AldaFux/Project-206-249/README.md

# Project-206-249
Repository for Final Project of classes 206 and 249
