AldaFux/Project-206-249/SampleMaterial/150708_Workshop_Kinematik.pdf

## Workshop

# Einführung in die Inverse Kinematik

FabLab Nürnberg – Johannes Heberlein

thingiverse.com/joo

## Geometrischer Ansatz zur mathematischen Modellfindung der inversen Kinematik eines quasi parallel verlinkten Roboterarms zur Stellwertfindung polar agierender Aktoren für einen im kartesischem Koordinatensystem agierenden Endeffektor

## Übersicht

- Grundlagen der Geometrie
- Grundlagen der Kinematik
- Übung/Beispiel Parallelroboterarm
- Plotclock erklärt
- Übung

## Geometrische Grundlagen

- Karthesisches und Polars Koordinatensystem – Pythagoras und Arkustangens
- Kosinussatz
- Z-Winkel
- Winkelfunktion Arduino

## Polare und Kartesische Koordinaten

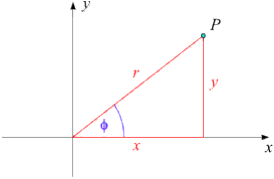
[picture p4: figure]

Kartesische Koordinaten Punkt P:

x = r·cos(φ)

y = r·sin(φ)

Polar Koordinaten

r = √(x² + y²)

tan(φ) = y/x

## Kosinussatz

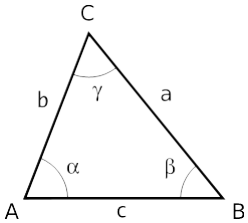
[picture p5: figure]

## Z-Winkel

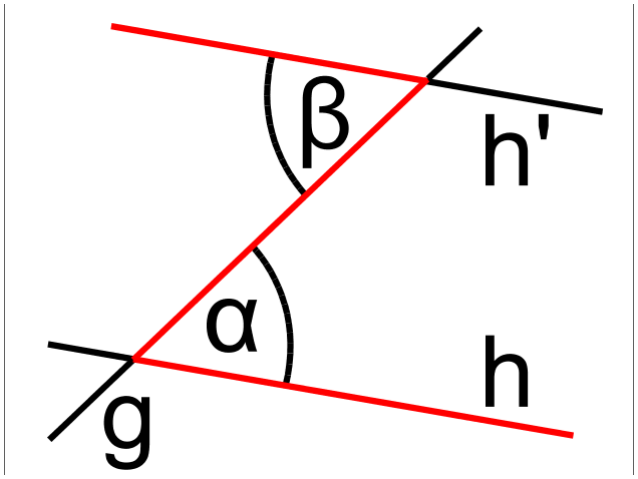
[picture p6: figure]

## Winkel in Arduino

- Winkel in Radian, gegen den Uhrzeigersinn Start bei „3 Uhr“
- atan2 unabhängig vom jeweiligen Quadrant
- Standard in den meisten Programmiersprachen

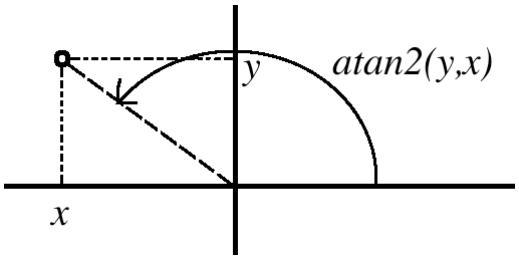
[picture p7: figure]

## Grundlagen der Kinematik

- Unterschied direkte und inverse Kinematik
- Freiheitsgrade
– n Formeln/Aktoren für n Freiheitsgrade
- Aktoren, Gelenke, Lager

## Unterschied direkte und inverse Kinematik

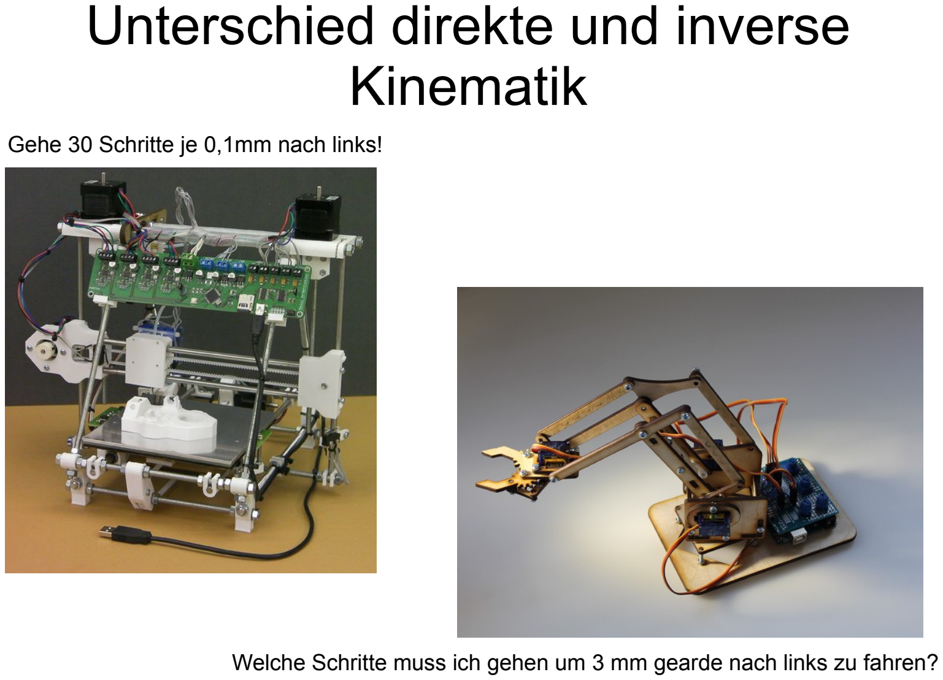
[picture p8: page 10]

Welche Schritte muss ich gehen um 3 mm gearde nach links zu fahren?

Gehe 30 Schritte je 0,1mm nach links!

## Freiheitsgrade

- Anzahl Aktoren bestimmt Anzahl der Freiheitsgrade:
- Lasercutter: 2 Schrittmotoren → 2D
- 3D Drucker: 3 Schrittmotoren → 3D
- Plotclock: 2 Servos (+1 Hub Servo) → „2.5D“

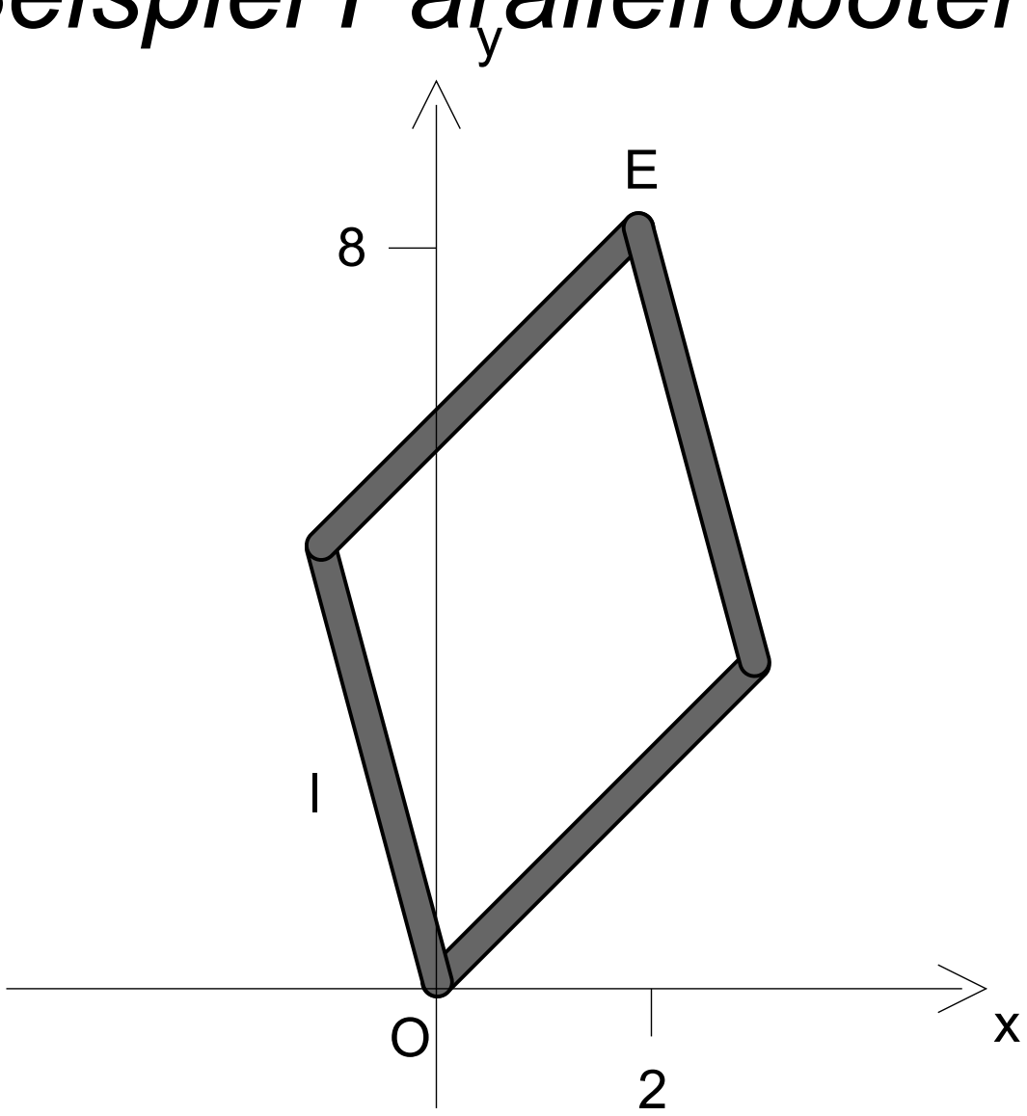
[picture p9: figure]

## Beispiel Parallelroboterarm

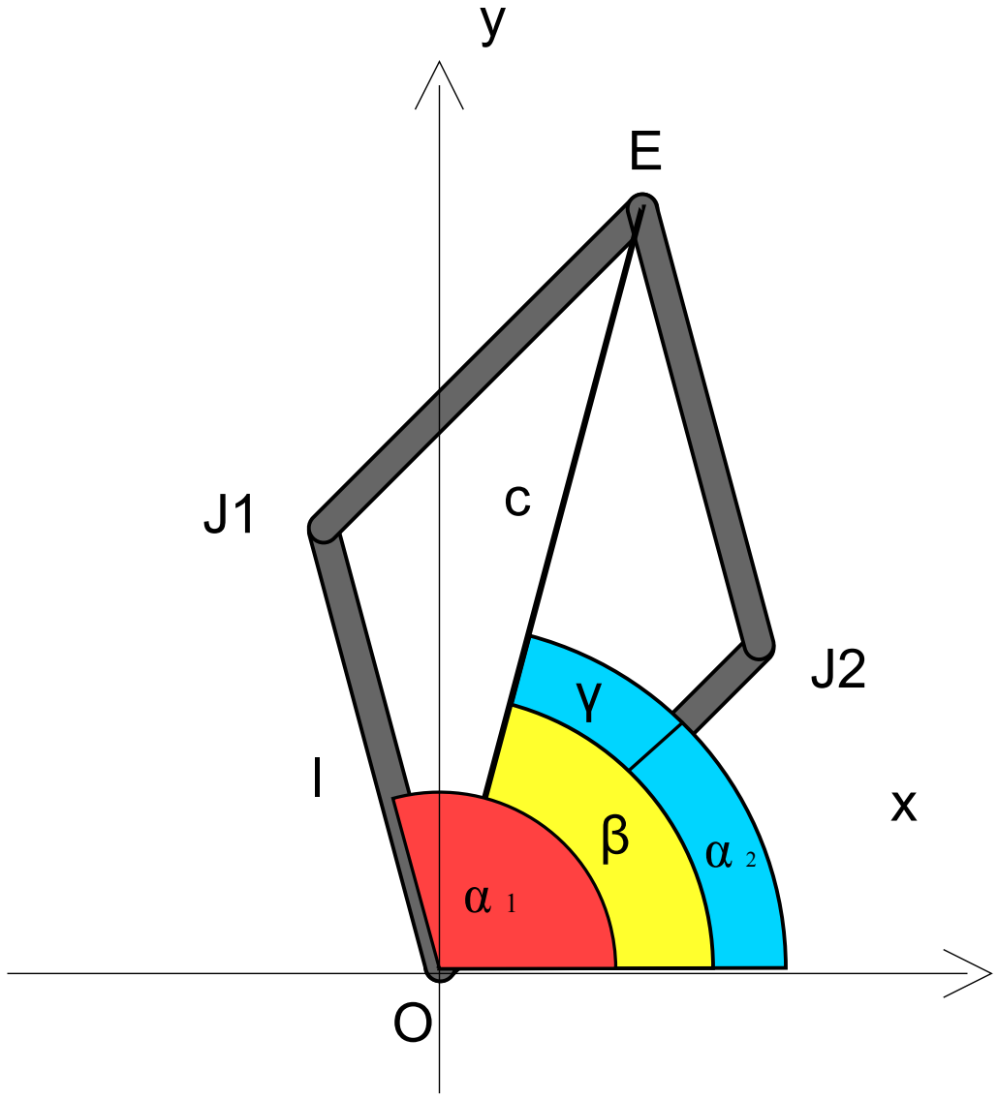
[picture p10: figure]

Gegeben:
O(0,0); E(2,8); l=6

Gesucht:
α 1 ; α 2

Winkelbedingungen:
β=atan2((Ey-Oy), (Ex-Oy))
β=atan2(Ey, Ex) -> 1,32rad

α 1 = β + γ
α 2 = β - γ

c = √((Ey-Oy)²+(Ex-Ox)²)
c = √(Ey²+Ex²) -> 8,25

-> einzig der Winkel γ fehlt

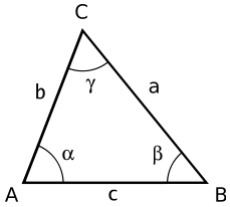
[picture p11: figure]

b²+c²-a²=2bc cos(α)

(b²+c²-a²)/2bc = cos(α)
α = acos( | ) (b²+c²-a²)
2bc
γ = acos( | )

(c*c+l*l-l*l)
2*c*l

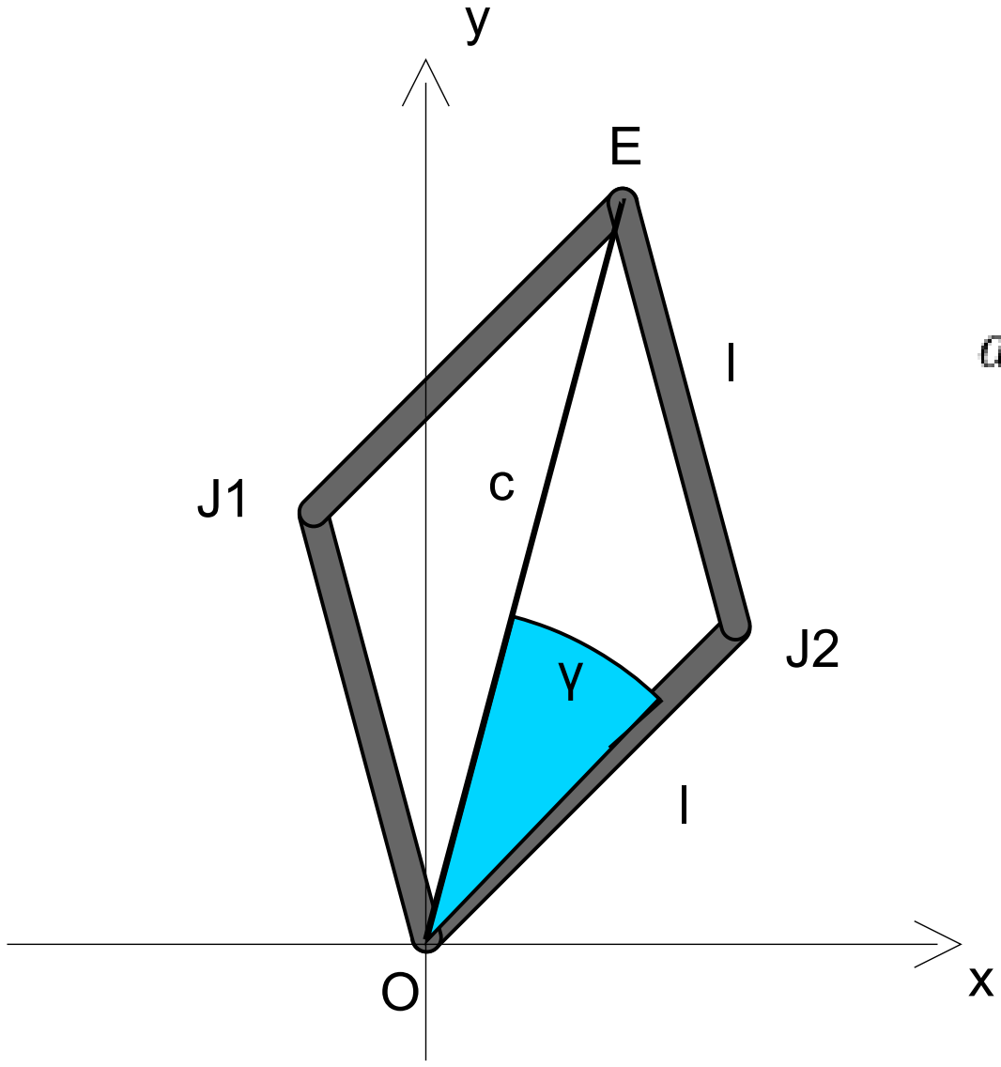
[picture p12: figure]

hier 0,813

γ = acos( )

c
2*l

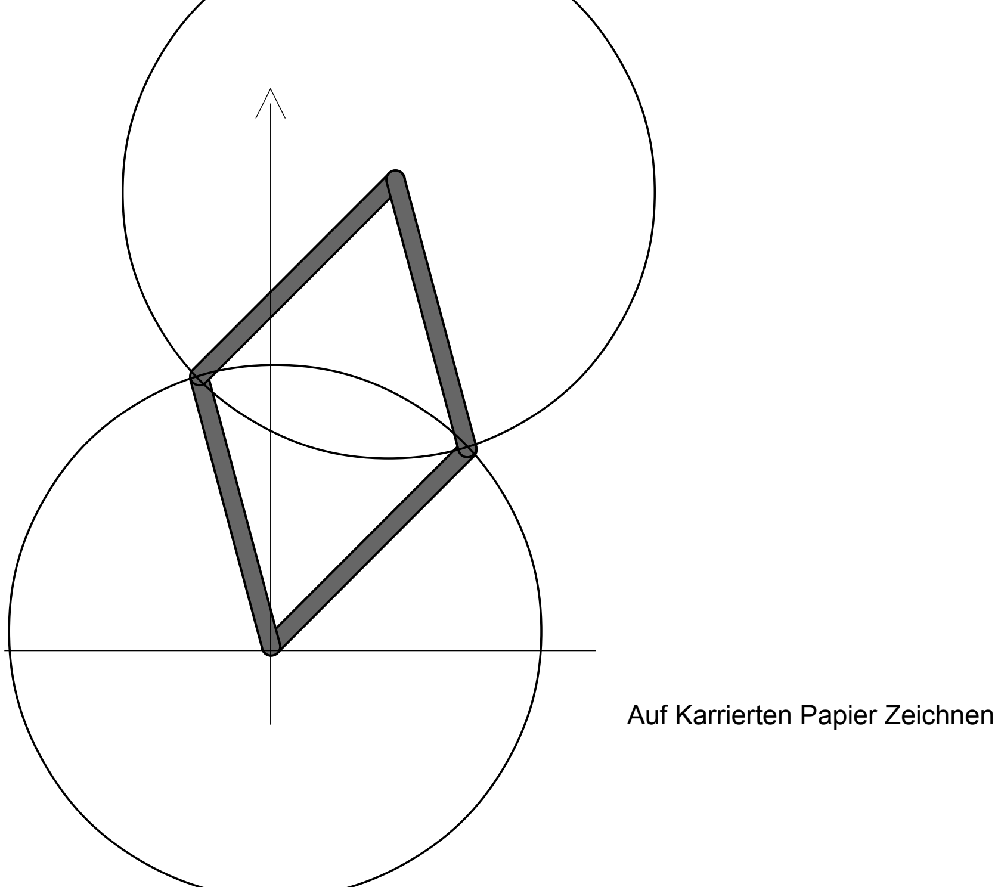
[picture p13: figure]
Auf Karrierten Papier Zeichnen

## Aktoren und Gelenke

- Schiene, Linearaktor, → Linie
- Servomotor, normales Gelenk → Kreis
- Kugelgelenk → Kugel

## Plotclock erklärt

## Vorschlag Übung
