AldaFux/Project-206-249/DocumentsForAssignments/InverseKinematics/InverseKinematicsMap.pdf

## Inverse Kinematics of the Robotic Manipulator

Patrick Scheffe, Nikolas Alberti

December 9, 2016

## 1 Simplified Kinematic Model

A simplified sketch of the robotic manipulator can be seen in Figure 1. As a first approx-imation it is useful to determine the angles θ1 to θ4 from the given position of the joint at which the two arms coincide (x,y). The key for solving this inverse kinematics problem is to divide it into smaller subproblems that each can be solved individually. For that purpose, the line segments a, b and c are introduced.
From the initial information, following values can be directly computed:

α = arctan y
x
(1)
β = π − α | (2)

c =

p
x

2 + y

2 | (3)

a =

s
x +

L3
2

2
+ y
2 | (4)

b =

s
x −

L3
2

2
+ y
2 | (5)

Now, you can solve for θ2 and θ3 by either using sine rule or cosine rule. However, the sine rule can be ambiguous in certain setups, which makes case differentiation necessary. Although mathematically steady, in our implementation the domain crossing from one solution to the other resulted in discontinuities of the movement. Therefore, the cosine rule solution is preferred:

θ2 = arccos

a

2 + ( L3
2

)

2 − c

2

aL3

!
| (6)

θ3 = arccos

b

2 + ( L3
2

)

2 − c

2

bL3

!
(7)

1

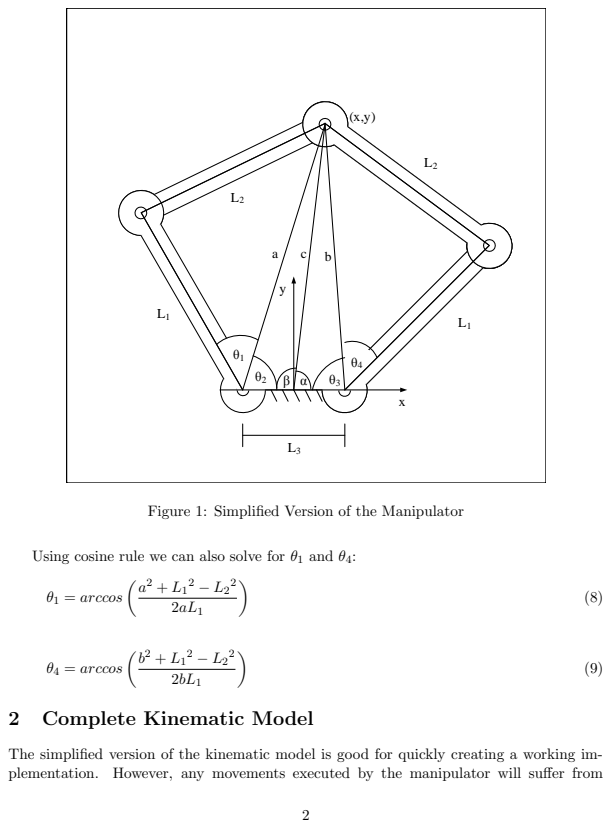
[picture p14: page 2]
θ1 = arccos ; θ4 = arccos 

Figure 1: Simplified Version of the Manipulator

Using cosine rule we can also solve for θ1 and θ4:

2 Complete Kinematic Model

The simplified version of the kinematic model is good for quickly creating a working im-
plementation. However, any movements executed by the manipulator will suffer from

distortion because the pen is not mounted exactly at the joint’s position but in a small distance. Hence, a precise solution is necessary. For that purpose, new definitions must be

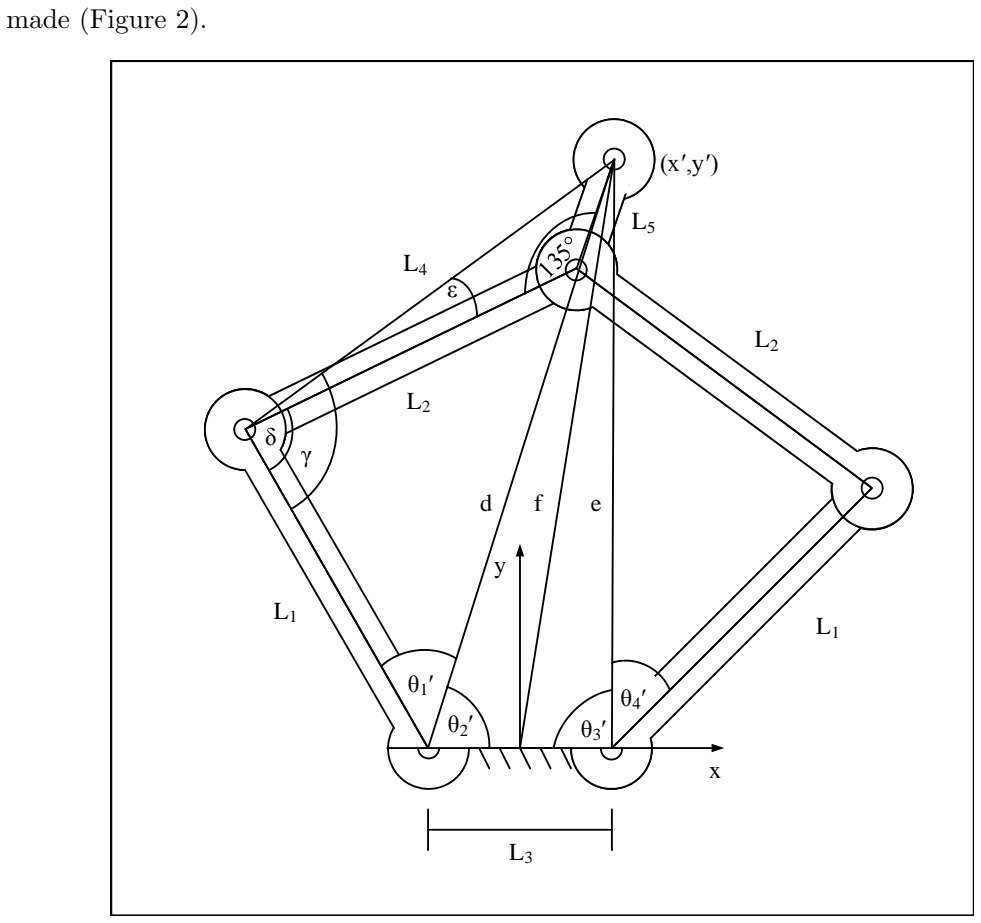
[picture p15: figure]
made (Figure 2).

Figure 2: Simplified Version of the Manipulator

L4 and are fixed measures and not influenced by the position of the manipulator:

L4 =

s
L2

2 + L5

2 − 2L5L2cos
3π
4
(10)

= arccos
L4

2 + L2

2 − L5

2

2L4L2

(11)

d, e and f can be yielded by the Pythagorean theorem:

f =

q
x

02 + y
02
(12)

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
(13)

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
(14)

Now, θ

0/2, θ

0/3 and δ can be computed:

θ

0
2 = arccos

d

2 + ( L3
2

)

2 − f

2

dL3

!
(15)

θ

0
3 = arccos

e

2 + ( L3
2

)

2 − f

2

eL3

!
(16)

δ = arccos
L4

2 + L1

2 − d
2

2L4L1

(17)

δ is the sum of and γ.

γ = δ − | (18)

That allows us to calculate some quantities of the simple kinematics model:

a =

q
L1

2 + L1

2 − 2L1L2cos (γ) | (19)

θ1 = arccos
a

2 + L1

2 − L2

2

2aL1

(20)

θ2 = θ

0
1 + θ

0
2 − θ1 | (21)

Finally, we are able to find the position of the joint at which the two arms coincide:

y = a sin(θ2) | (22)

x = a cos(θ2) −

L3
2

(23)

Now, the methods from section 1 can be used to solve for θ3 and θ4.

4
