AldaFux/Project-206-249/DocumentsForAssignments/ProjectReport149/eecs149-project-template/eecs149-project-template/eec149-template.pdf

# Tic-Tac-Tobot

## [EECS 149/249A Class Project]

## Patrick Scheffe

## p.s@berkeley.edu

## Nikolas Alberti

## nikolas.alberti@berkeley.edu

Department of Electrical Engineering and Computer Science University of California

### Berkeley, CA

## ABSTRACT

## 1. INTRODUCTION

Our charter defines the goal of this project as follows: ”In this project, we want to build a robot that will challenge you to play a game of Tic-Tac-Toe. [...]The robot will control the movement of a whiteboard marker using two servos. The pen will be set up in a construction which has a shoulder and an elbow joint, so it can be moved to a defined x-y-position. The whiteboard is mounted in a fixed position next to the manipulator. First, the robot draws the playing field consisting of nine tiles. A camera will be used for monitoring the player’s move (placing a circle or a cross). Autonomously, the robot will react and make its own move. In order to make space for the human player’s moves, the whole construction should be able to move away from the field.”
This definition specifies well what the robot should be capable of doing. In order to meet the specification, a robotic manipulator must be assembled and controlled. Moreover, a computer vision component must be set up. At the end, a program joins these components, allowing it to keep track of the game and to compute the robot’s next move.

## 2. HARDWARE

## 2.1 Arduino Uno

The Arduino Uno is a microcontroller board equipped with an Atmel ATmega328P microcontroller [Atm]. Arduino is an open-source hardware and software project originated in Ivrea, Italy [Ard]. Hardware and software have been distributed by the founders of Arduino (known as Arduino LLC) and the producer of the official Arduino boards (Arduino S.r.l.). The goal of the Arduino project is to make the development on embedded systems as accessible as possible. For instance, the Arduino IDE completely hides technical details like header files from the user.
The Arduino has 14 GPIO pins from which 6 support pulse width modulation (PWM). Since PWM is needed for controlling servo motors, the Arduino matched our requirements. A plus point on the Arduino was that it promised to offer an uncomplicated development.

## 2.2 Servo Motors

For the actuation, we used three Tower Pro MG90S servo motors [Ser]. The connection to the Arduino was established with ordinary jumper cables. The power from a 5V/2A power supply was distributed with a breadboard to provide power for all three servo motors. Because the power supply originally ended in a coaxial power connector, we modified it to have jumper cables as output for positive and negative voltage.

## 2.3 Additional Materials

Additionally, the following materials have been used:

- A Microsoft LifeCam HD-3000 webcam
- A white board
- Two white board markers
- Some screws, nuts and bolts
- ABS filament for 3D printing the custom parts

## 3. ROBOTIC MANIPULATOR

## 3.1 Choosing the dimensions

For accurate two dimensional actuation, a classical robotic manipulator that consists of a chain of dependent joints is not suitable for a low budget approach. The plotclock, a project by Johannes“Joo”Heberlein from the Fablab Nuremberg (comparable to a makerspace) impressively proved a way to make low budget 2D actuation work [Joo]. Therefore, we planned to choose a similar manipulator. However, while the plotclock needs to cover a range whose dimensions in x-direction exceed the dimensions in y-direction, it was not possible to blindly adapt the manipulator. For our project, actuation needs to be performed in a square area. Therefore, we needed to find the optimal sizes of the limbs. This problem can be described as a minimization problem: The area of a square is given. Find the dimensions L1, L2 and L3 that minimize the sum L1 + L2 + L3 while not violating the constraints that the given square fits into the reachable range of the actuator.
Unfortunately, the function of the largest reachable square A(L1, L2, L3) is not defined by a function that allows for partly deriving towards L1, L2 and L3 and setting the derivations to zero. Formulating this problem as a minimization problem to solve with MATLAB for example seemed to WAAAAAAS. We therefore chose to model the reachable space in a geometry software called Geogebra, an open source software for supporting mathematical education in schools and universities [Geo]. Then, we empirically derived a near optimal sizing that yields a reachable square of approximately 100cm²
(Figure 2). A constraint was that we


Figure 1: Geogebra Sketch Used for Sizing

wanted the player to face the robot like they would sit on opposite ends of a table. Consequently, choosing orientation of the square freely to allow a better usage of the space was not possible.

## 3.2 Manufacturing

Finding the right dimensions was a crucial part for building the robot. After finding those, a CAD model of the manipulator was created using Autodesk Inventor [cad]. Those models were converted to STereoLithography (STL) files and printed with the ROSTOCK MAX v3 3D printer in the Supernode lab [3D]. It was important to find the right bed temperature and extrusion speed to avoid warping and have the parts stick to the printing bed.
The joints of the five-bar linkage robot were connected with screws and washers of the right size. To allow the arms of the robot to lift from the whiteboard, the two servomotors actuating the arms can be tilted backwards with a bar connected to their mounting. This bar is also connected to the third servomotor, which is mounted below the whiteboard.

## 3.3 Simplified Kinematic Model

A simplified sketch of the robotic manipulator is shown in Figure 2. As a first approximation it is useful to determine the angles θ1 to θ4 from the given position of the wrist joint at which the two arms coincide (x,y). The key for solving this inverse kinematics problem is to divide it into smaller subproblems that each can be solved individually. For that purpose, the line segments a, b and c are introduced.
From the position of the wrist joint, the following values can be computed directly:

α = arctan

y
x

β = π − α

c =

p
x² + y

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
Now we can solve for θ2 and θ3 by either using sine rule or cosine rule. However, the sine rule can be ambiguous in certain setups, which makes case differentiation necessary. Although mathematically steady, in our implementation the

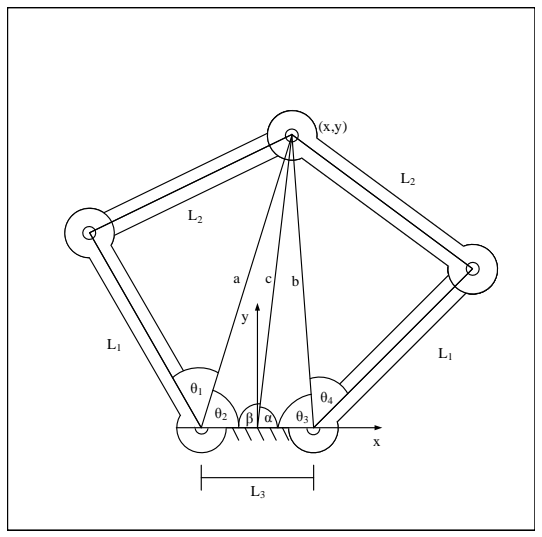
[picture p16: figure]

Figure 2: Simplified Version of the Manipulator

domain crossing from one solution to the other resulted in discontinuities of the movement. Therefore, the unambiguous cosine rule solution is preferred:

θ2 = arccos

a

2 + ( L3
2

)

2 − c

2

aL3

!

θ3 = arccos

b

2 + ( L3
2

)

2 − c

2

bL3

!

Using cosine rule we can also solve for θ1 and θ4:

θ1 = arccos
a

2 + L1

2 − L2

2
2aL1

θ4 = arccos
b

2 + L1

2 − L2

2
2bL1

## 3.4 Complete Kinematic Model

The simplified version of the kinematic model is good for quickly creating a working implementation. However, any movements executed by the manipulator will suffer from distortion. The pen is not mounted exactly at the joint’s position but in a small distance. Hence, a precise solution is necessary. For that purpose, new definitions are made as shown in Figure 3.
L4 and are fixed and not influenced by the position of the manipulator:

L4 =

s
L2

2 + L5

2 − 2L5L2cos
3π
4

= arccos
L4

2 + L2

2 − L5

2
2L4L2

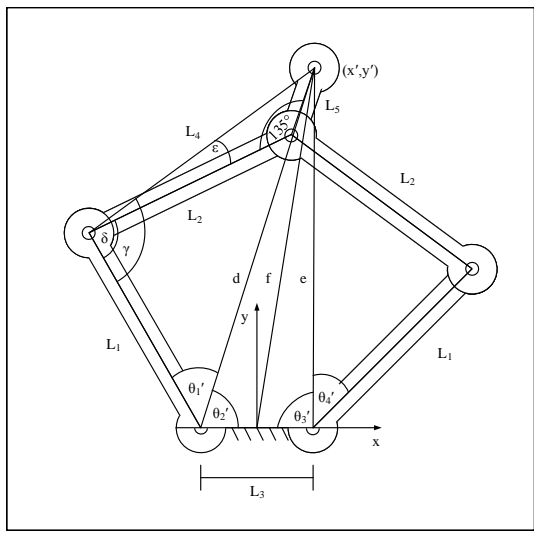
[picture p17: figure]

Figure 3: Complete Version of the Manipulator

d, e and f are found with the Pythagorean theorem:

f =

p
x⁰² + y

02

d =

s
x⁰ +

L3
2

2
+ y

02

e =

s
x⁰ −

L3
2

2
+ y

02

Now, θ

0
2, θ

0
3 and δ can be computed using cosine rule:

θ

0
2 = arccos

d

2 + ( L3
2

)

2 − f

2

dL3

!

θ

0
3 = arccos

e

2 + ( L3
2

)

2 − f

2

eL3

!

δ = arccos
L4

2 + L1

2 − d

2
2L4L1

δ is the sum of and γ.

γ = δ −

That allows us to calculate some quantities of the simple kinematics model:

a =

q
L1

2 + L1

2 − 2L1L2cos (γ)

θ1 = arccos
a

2 + L1

2 − L2

2
2aL1

θ2 = θ

0
1 + θ

0
2 − θ1

Finally, we are able to find the position of the joint at which the two arms coincide:

y = a sin(θ2)

x = a cos(θ2) −

L3
2
Now, the methods from subsection 3.3 can be used to solve for θ3 and θ4.

## 3.5 Modeling the Servo Motors

Servo motors are motors that do not support continuous motion but can be driven to a desired angle precisely. Three cables with different colors connect to the servo motors. The black cable should be connected to ground and the red one to VDD (roughly 5V). These two cables supply the servo motor with the necessary power. The third cable (white, yellow or orange) carries the control signal. The control is done by PWM. The servo motor expects to receive a pulse every 20 ms with a pulse width between 1 ms and 2 ms. The servo motor assumes its most positive position at the the pulse width of 1 ms and the most negative position at a pulse width of 2 ms as defined in the mathematical direction of rotation. The range in between these extrema can be assumed to be linearly covered, i.e. a pulse width of 1.5 ms should yield the position in between these positions. The function that maps the pulse width to an angular position of the servomotor is:
Angle(tpulse) = tpulse − 1 ms
2 ms − 1 ms
- (Anglemax − Anglemin)

+ Anglemin, 1 ms ≤ tpulse ≤ 2 ms

This is just a model of the movement of the servo motors. There are three causes making the actual behavior deviate from the model:

- A high torque forces the servo motors from leaving its desired position.
- The backlash of the gears in the servo motors adds an inaccuracy to the position.
- Non-linearities make the servomotor cover the range of movement not evenly.

Furthermore, when the pulse width modulation signal is created by a digital signal, a quantization error occurs. As you can see, the model makes some approximations. The inner of the servo motor is treated as black box. However, adding the details would bloat the model and the gain is questionable. The proposed model is precise enough to be useful but not so complex that it becomes cumbersome.

## 4. SOFTWARE ON THE ARDUINO

## 4.1 Overview over the software structure

Every program written with the Arduino IDE consists of the function void i n i t ( ) and void l o o p ( ). The i n i t ( ) function is executed once at startup and afterwards the Arduino keeps looping through the l o o p ( ) function. That is, because as a typical microcontroller, the Atmel ATmega328P, does not have an operating system and can not just end a task. In addition, following major functions have been defined:

- void l owe r ( ) lowers the marker.
- void l i f t ( ) removes the marker from the surface.
- void c alcul a teSe r v oM ap (double x prime ,
double y prime , double* | s e r v o L s ol l ,
double* | s e r v o R s o l l ) calculates the values that
should be written to the servo motors given an x-yposition.

- void s e t s e r v o s (double x , double y ) calls c alcul a teSe r v oM ap and writes to the servo motors.
- void g o t o (double xto , double yto ) interpolates between the current position and the desired position of the manipulator and successively sets the position of the servo motors using s e t s e r v o s ( ) in order to achieve a smooth movement between the origin and the destination position.
- void draw { c r o s s , c i r c l e }(double x o f f s e t , double y o f f s e t ) draws cross/circle to any position defined by a passed x-y-position.
- d r a w f i e l d ( ) draws the playing field.

The main functionality is implemented in the l o o p ( ) function: The processor waits for an instruction coded in a byte sent from the master. Once it receives the command, it is executed and followed by sending an acknowledgment signaling that it has finished the execution.

## 4.2 Controlling the Servo Motors

The Arduino Uno has six PWM pins available. Very conveniently, the Arduino IDE already is equipped with a library Servo. This library allows us to instantiate objects of the type Servo. The most important functions on this object are a t t a c h ( ) and w ri t e ( ). The a t t a c h ( ) function assigns the Servo object to a GPIO pin. The w ri t e ( ) maps an angle in the range of 0◦

to 180◦
to a pulse width and
makes the attached GPIO pin output the according PWM. Inherently, a reachable range of 180◦
is assumed for the servo
motor. However, our servo motors only are capable of spinning 150◦
. Signals that exceed the range of approximately 15◦

to 165◦
are simply ignored.
Additionally, the servo hat can only be placed onto the servo motor at certain angles. Therefore, the angle due to this offset also needs to be considered.

#def ine le f tM ax 161

#def ine rightMax 16

void c alcul a teSe r v oM ap ( . . . ) {
* s e r v o L s o l l = le f tM ax − ( pi − ( t h e t a 1+t h e t a 2 ) ) * 180/ pi ; * s e r v o R s o l l = rightMax + ( pi − ( t h e t a 3+t h e t a 4 ) ) * 180/ pi ;
}

Listing 1: Finding the right angle

## 5. SOFTWARE ON THE COMPUTER

## 5.1 Computer Vision

The Python package OpenCV [CV] was used to process the images from the camera in order to register the user input. The basic steps to find the lines drawn on the whiteboard are to convert the image to grayscale and then to binarize it to black and white.
There are two main tasks for the vision: The first is to detect where the field is drawn, so the circle or cross drawn by the user can be assigned to a specific tile of the field. This

Figure 4: Convexity defects for a cross

is achieved by looking for the innermost contour of the lines drawn. Wrong detection is avoided by thresholding with the contours enclosed area. The corners of this inner field is then transformed so that the field coordinates are mapped to pixels.
The second task is to decide if the input drawn by the user is a cross or a circle. The convexity defects were used as the property of those signs to tell them apart. The convexity defects quantify the local maximum of the deviation of the contour to its convex hull as shown in Figure 4. For a circle or a different convex shape, there should be no convexity defects at all. Every convex shape will be detected as a circle consequently. This method of detection can therefore produce wrong rights, but the differentiation between circles and crosses is robust.

## 5.2 Tic-Tac-Toe AI

The simple and well known game Tic-Tac-Toe is already fully explored and algorithms to play the game optimally are available. Also, the relatively small state space of the board make exhaustive search for an optimal solution possible. The concept of the algorithm used in our implementation is nicely explained in [NSB]. Furthermore, [vdS] provides a similar implementation of the game in Python. Although it heavily relies on the functions only available in a GUI environment, it served as a useful reference.
Since the detailed explanation can be found in [NSB], only the principle is summarized here: A 3×3 2D-array represents the nine tiles in the field. On each move, the algorithm iterates over the tiles and when it encounters an empty tile, it recursively calls itself to simulate the progress of the game. Doing so, an altered board with the new move and another active player is passed. The break condition is either that one of the players has won or there is no free gap anymore. The original caller chooses the move that offers the best outcome with the minimum number of recursive calls in case of a win and the maximum number of recursive calls in case of a loss. It is a typical example of a minimax algorithm. The described algorithm plays optimally, in a meaning that it is impossible to win against it. Also, in case a win can be enforced, the computer finds this optimal path to the win. It lacks an understanding for common human mistakes and assumes the opponent to play optimally himself. In order to offer some kind of a sense of achievement to the player, the algorithm is disabled with a probability of 15%

and a random move is made.

## 5.3 The Game Program

Having described each part separately, the only thing left is combining each part to form a robot that autonomously plays Tic-Tac-Toe. A superordinate loop sets up the playing field and reads the player’s decision whether he wants to start or not. In order to completely decouple the game from an input on the computer, we made the design choice that the first player’s sign is the cross and the second player’s sign is the circle. With that definition, the decision whether the player or the computer should start the game is made by drawing either a cross (“I want to start!”) or a circle (“The computer should start!”) to the right of the playing field. Once the setup is done, a subordinate loop is started that breaks after nine subsequent moves or when on one of the players has won.
For the serial communication with the Arduino, the library p y s e r i a l [PyS] has been used.

## 6. REFERENCES

[Atm] Atmel: ATmega328P Manual (https://cdn.sparkfun.com/datasheets/Kits/doc8161.pdf.)
[Ard] Arduino LLC: Arduino UNO & Genuino UNO (https://www.arduino.cc/en/Main/ArduinoBoardUno) [Ser] Adafruit: Micro Servo - MG90S High Torque Metal Gear (https://www.adafruit.com/products/1143)
[Joo] Johannes “Joo” Heberlein: Plotclock, (http://www.thingiverse.com/thing:248009) Nuremberg(2014), published under the Creative Commons - Attribution license (https://creativecommons.org/licenses/by/3.0/)
[Geo] Markus Hohenwarter et al.: Geogebra, software published under a free, non-commercial license; (https://www.geogebra.org/license) source code (https://dev.geogebra.org/trac) published under the GNU General Public License (http://www.gnu.org/licenses/gpl.html)
[cad] Autodesk: Inventor (http://www.autodesk.de/products/inventor/overview)
[3D] SeeMeCNC: ROSTOCK MAXˆaD´c V3 DESKTOP ˇ 3D PRINTER DIY KIT (https://www.seemecnc.com/products/rostock-max-v3-desktop-3d-printer-diy-kit)
[CV] Itseez: OpenCV, (http://opencv.org) software published under a BSD-license (http://opencv.org/about.html)
[NSB] Never Stop Building LLC: Tic Tac Toe: Under standing The Minimax Algorithm(2013) (http://neverstopbuilding.com/minimax)
[vdS] Mauritz van der Schee: Python TicTacToe with Tk and minimax AI(2013) (https://www.leaseweb.com/labs/2013/12/python-tictactoe-tk-minimax-ai/)
[PyS] Chris Liechti:pyserial(2001) (https://pythonhosted.org/pyserial/)
