AldaFux/Project-206-249/DocumentsForAssignments/ProjectReport149/eecs149-project-template/eecs149-project-template/flies-eps-converted-to.pdf

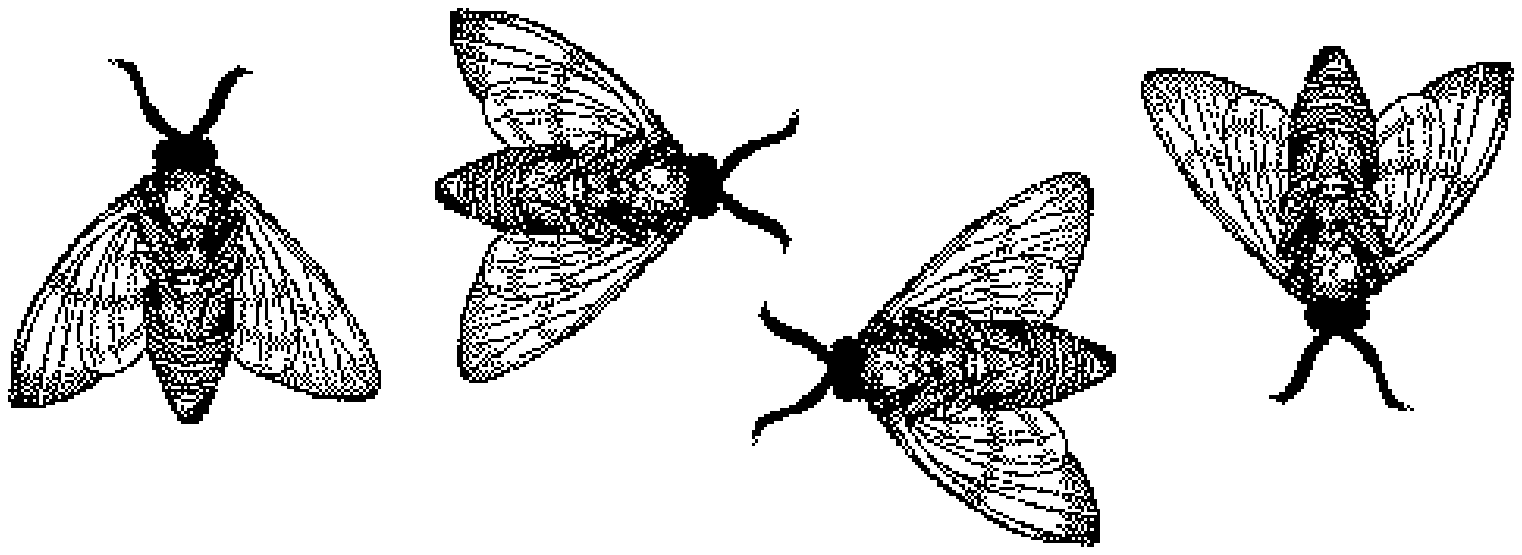
[picture p18: page 1]
