AldaFux/Project-206-249/DocumentsForAssignments/ProjectReport149/eecs149-project-template/eecs149-project-template/fly-eps-converted-to.pdf

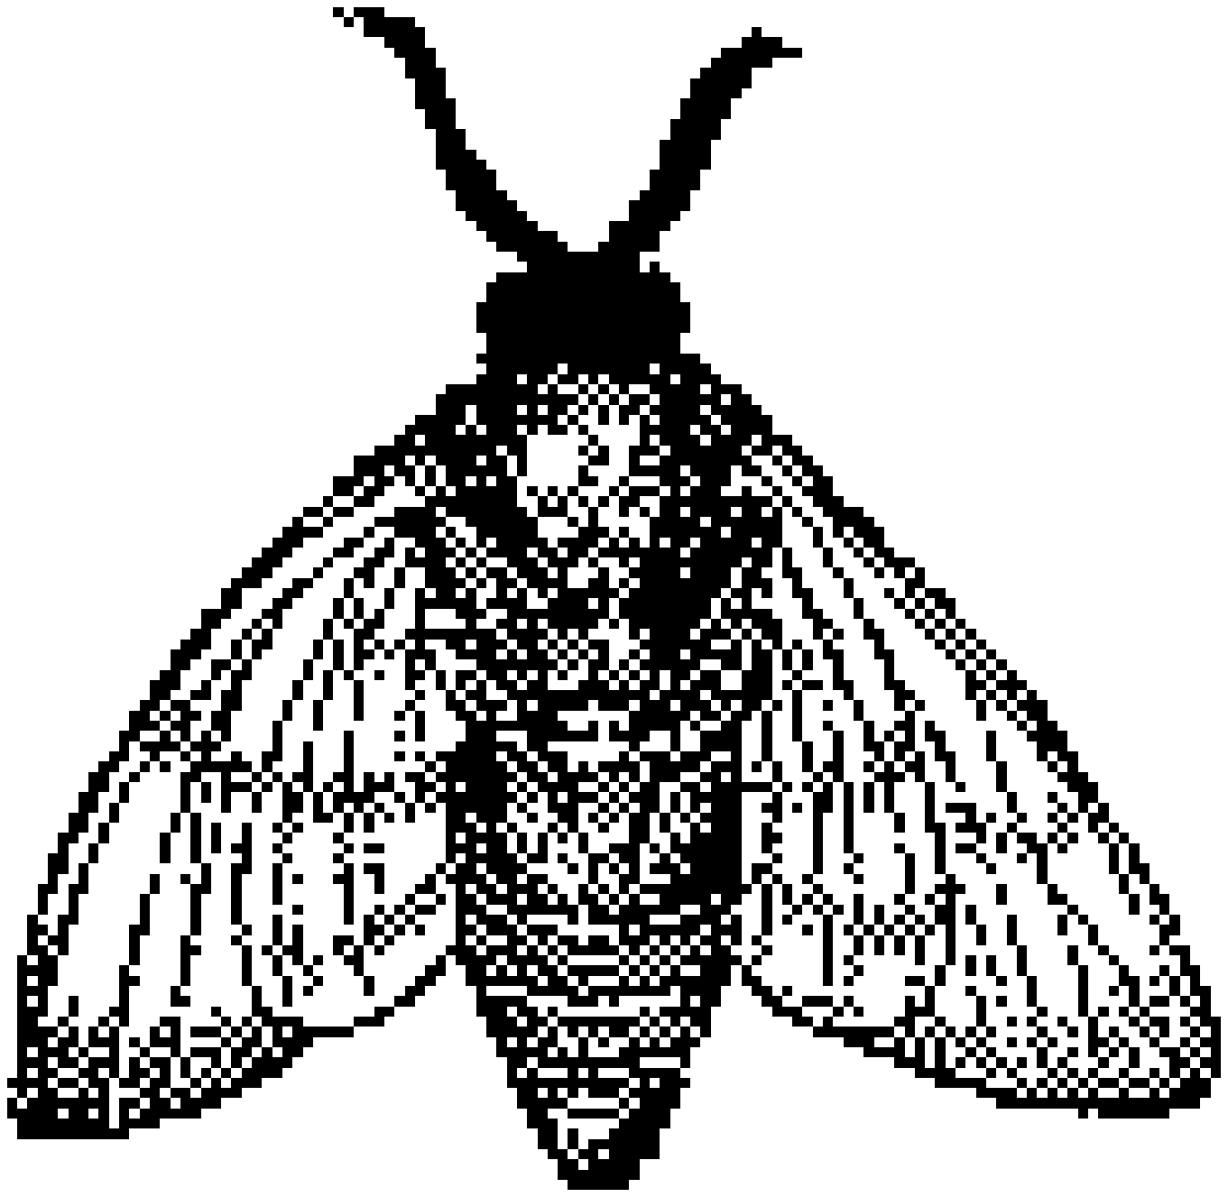
[picture p19: page 1]
