AldaFux/Project-206-249/DocumentsForAssignments/ProjectReport149/eecs149-project-template/eecs149-project-template/img/cnvxHullCross.pdf

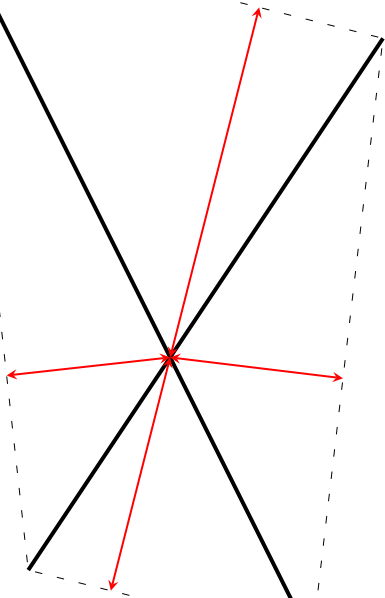
[picture p20: figure]
