AldaFux/Project-206-249/DocumentsForAssignments/robot.jpg

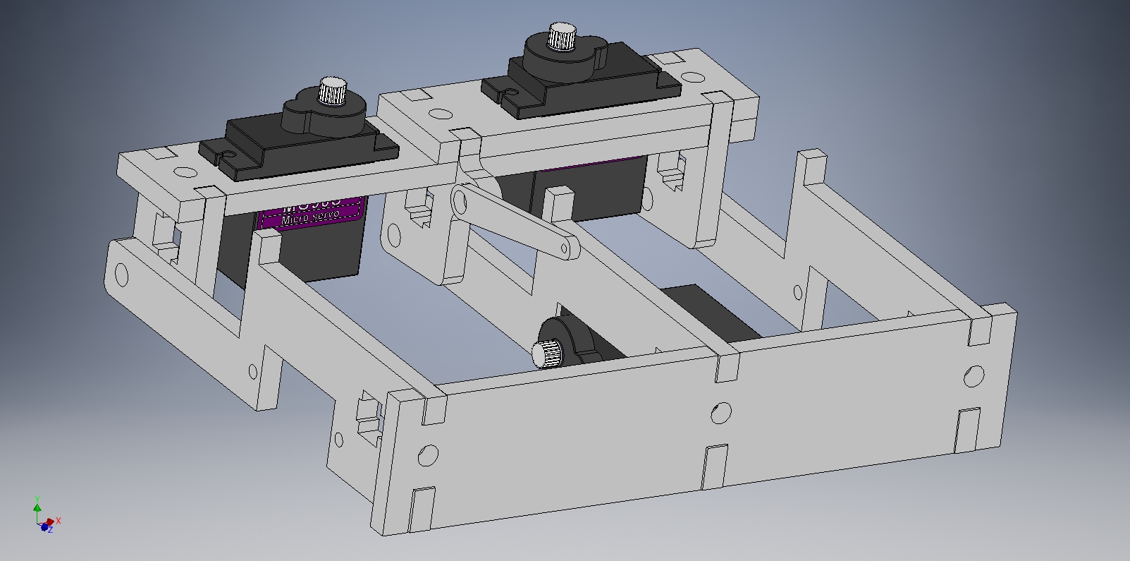
DocumentsForAssignments/robot.jpg
