AldaFux/Project-206-249/DocumentsForAssignments/tokensDetected.jpg

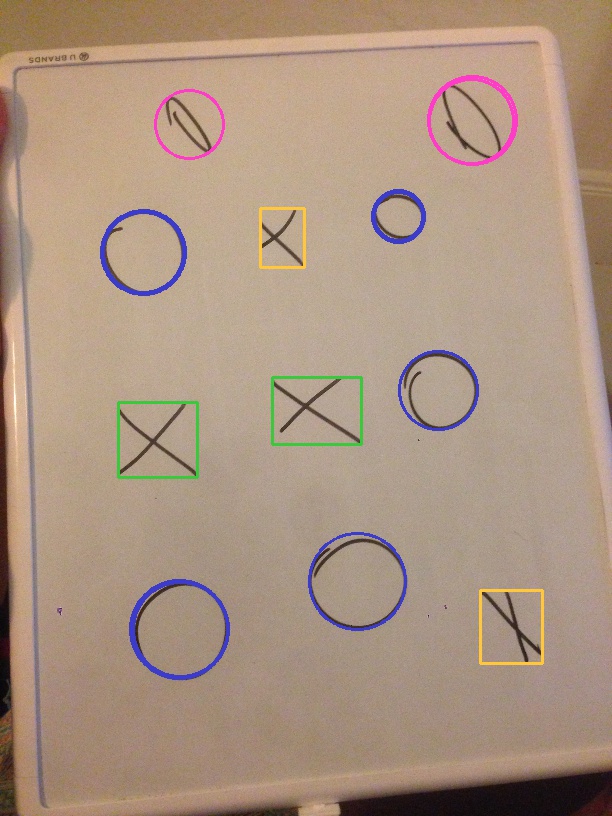
DocumentsForAssignments/tokensDetected.jpg
