AldaFux/Project-206-249/DocumentsForAssignments/Parts.xlsx

Link | Product | Cost
https://www.adafruit.com/products/3055 | Raspberry Pi 3 Model B | 40 | TOTAL COST
https://www.adafruit.com/products/239 | Breadboard | 6 | 183
OUT OF STOCK | Mini Aluminium Heat Sink | 1
https://www.amazon.com/Samsung-Select-Memory-MB-ME32DA-AM/dp/B01DOB6Y5Q/ | Micro SD card | 10
https://www.adafruit.com/products/2307 | 3 Servos | 36
https://www.adafruit.com/product/1995 | Power Supply | 8
https://www.adafruit.com/products/2327 | Servo Hat | 18
https://www.adafruit.com/products/276 | Power Supply Servo Hat | 8
https://www.adafruit.com/products/50 | Arduino Uno R3 | 25
https://www.adafruit.com/product/1957 | Jumper Cables | 2
https://www.amazon.com/Brands-Contempo-Magnetic-Erase-Inches/dp/B00PRYQQES/ | Whiteboard | 8
https://www.adafruit.com/product/954 | Usb to TTL Serial Cable | 10
https://www.adafruit.com/products/608 | HDMI Cable | 5
https://www.amazon.com/Expo-Erase-Markers-Black-86001/dp/B000N35G5S | Whiteboard Markers | 6
