AldaFux/Project-206-249/DocumentsForAssignments/githubSetup.docx

# Tic Tac Tobot – Github Setup

We do the version control on our project files with Github. The repository contains three folders:

Code | Where the code for the computer vision, the actuation of the motors and the play algorithm is stored
DocumentsForAssignments | Where documents we have to deliver are stored
SampleMaterial | Where inspiring or useful work of others is stored

The structure of the repository will be changed dynamically with the needs of the programming environments.

Nikolas Alberti – nikolas.alberti@berkeley.edu EECS 249A Project Charter Patrick Scheffe – p.s@berkeley.edu Fall 2016
