AldaFux/Project-206-249/DocumentsForAssignments/ProjectReport149/eecs149-project-template/eecs149-project-template/rosette-eps-converted-to.pdf

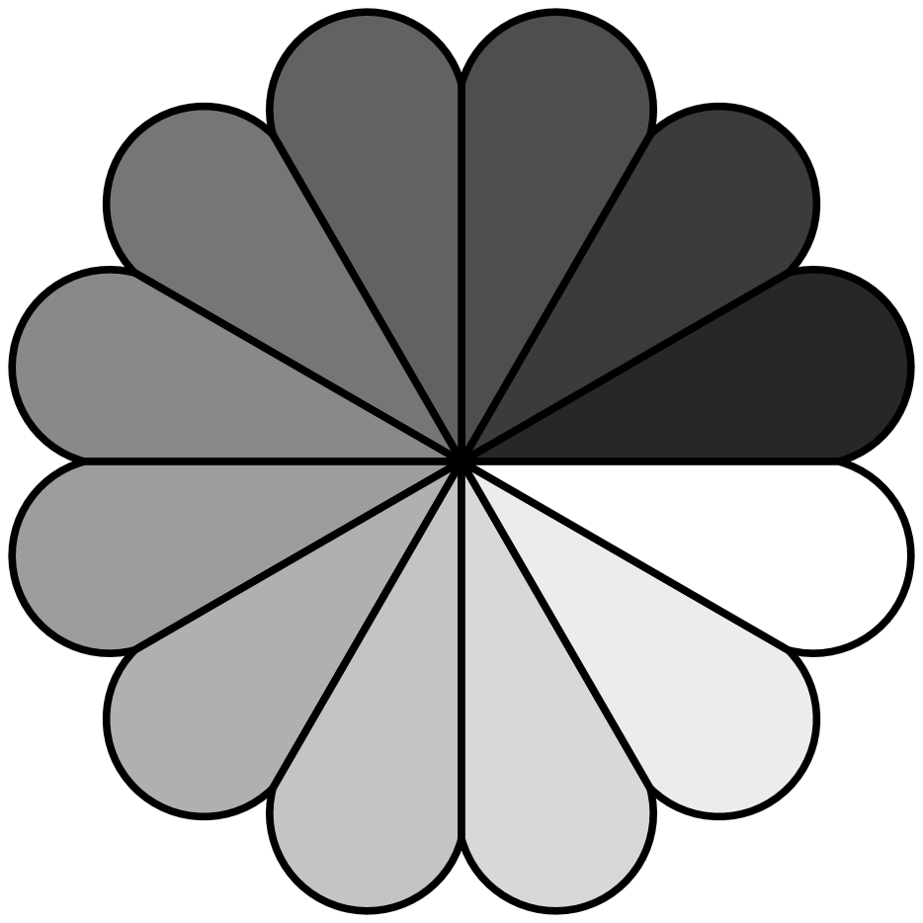
[picture p23: page 1]
