AldaFux/Project-206-249/DocumentsForAssignments/ProjectReport149/eecs149-project-template/eecs149-project-template/img/LinkDiagramComplicated.pdf

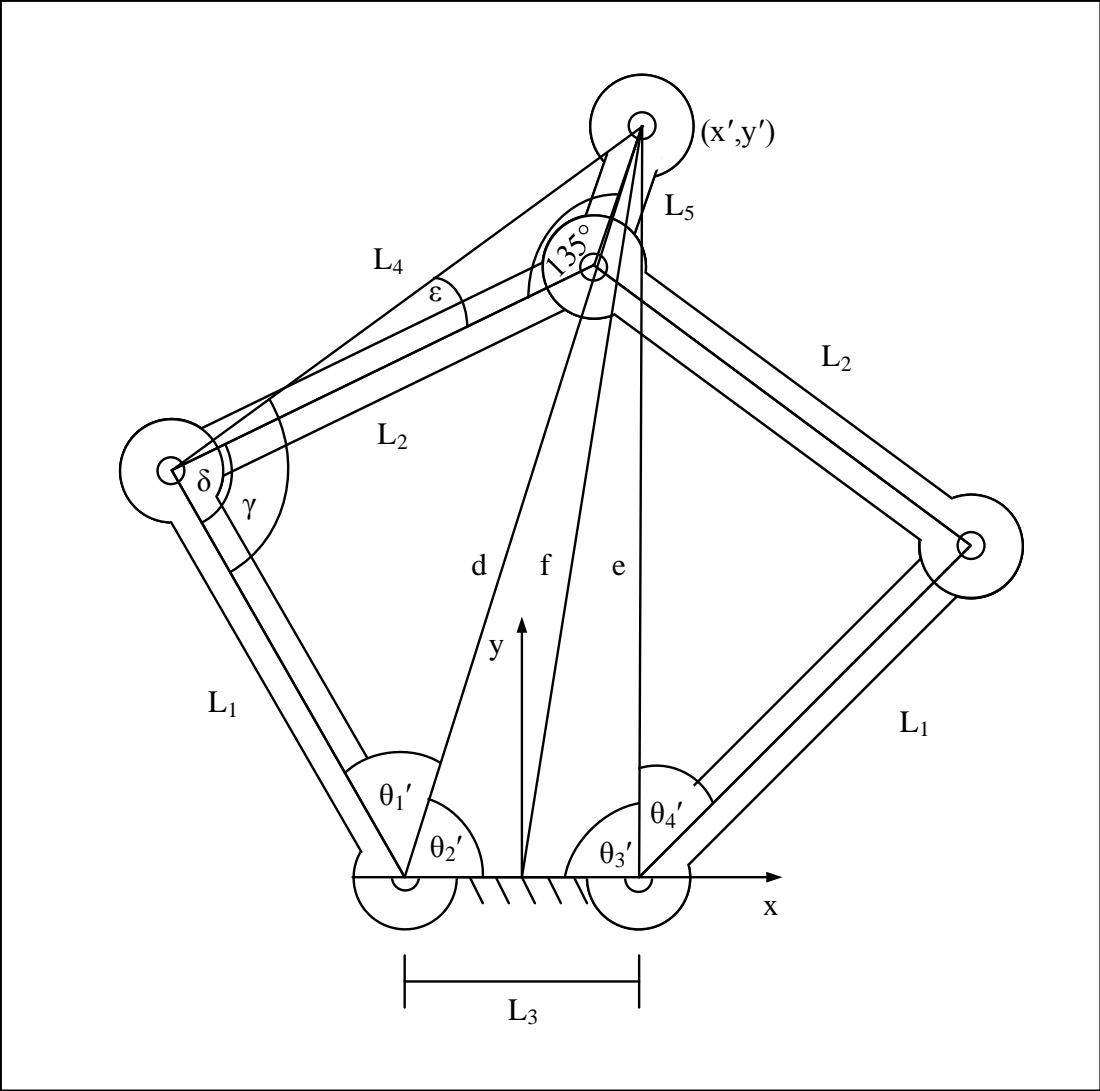
[picture p24: page 1]
