AldaFux/Project-206-249/DocumentsForAssignments/ProjectReport149/eecs149-project-template/eecs149-project-template/img/LinkDiagramSimple.pdf

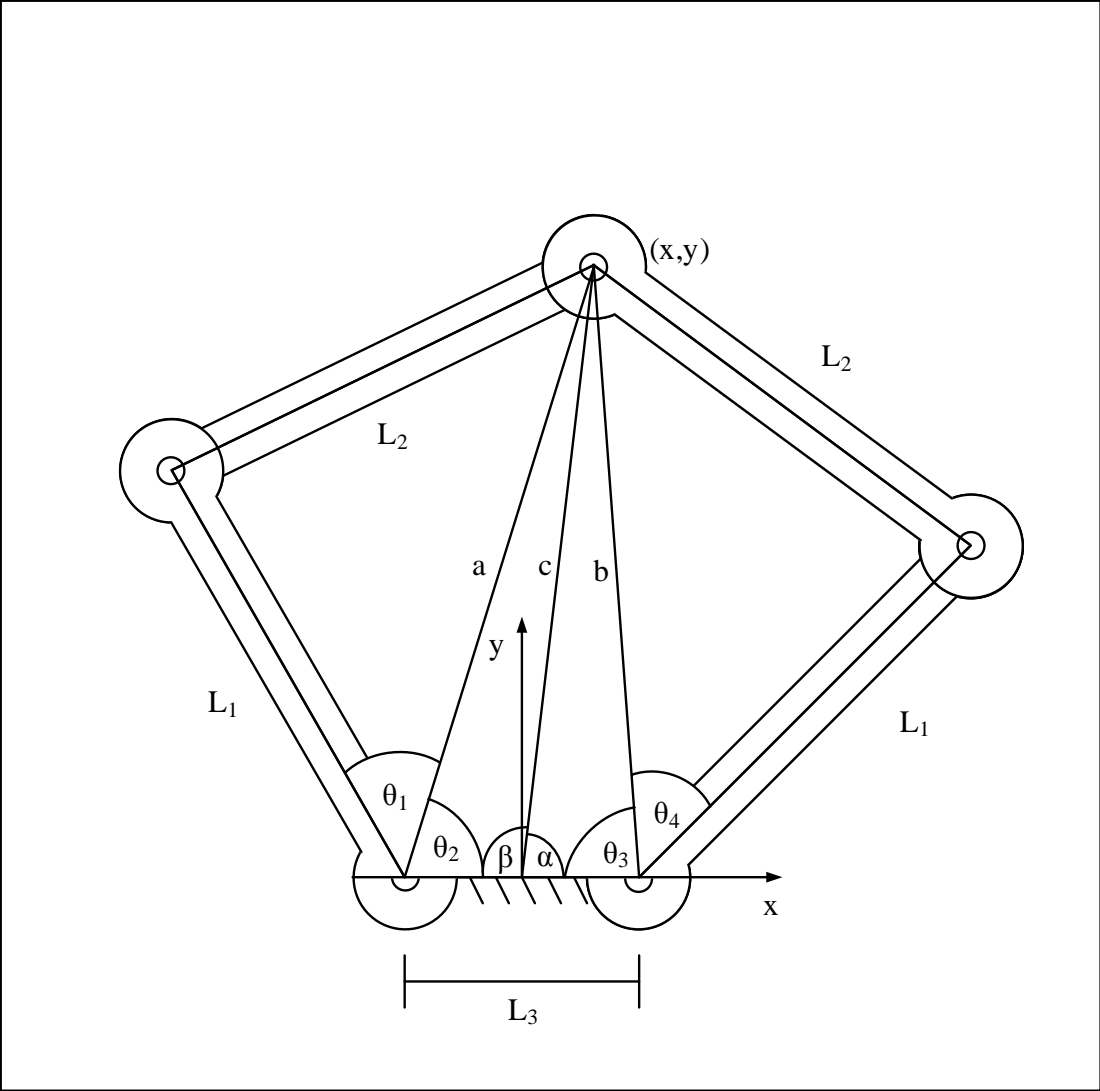
[picture p25: page 1]
