AldaFux/Project-206-249/(commit log)

2016-10-20 Files that we have so far
    Trying to keep everything at one place. Therefore managing these files
    with github now.
    [Parts.xlsx]
2016-10-23 parts list updated
    [Parts.xlsx]
2016-12-04 Likelihood for mistake of the computer implemented
    Likelihood for mistake of the computer implemented and the computer can
    recognize the sign of the user and no window opens p anymore.
    [servoControl.ino, tictactoe_server.py]
2016-12-08 Structure change & Vision update
    -Changed structure in folder 'code'
    -Reverted sign detection
    [Serial.py, servoControl.ino, tictactoe_server.py]
